HarisGusic/rotating-led-display/README.md

# Rotirajući LED displej

Korišten je mikrokontroler Arduino Mega 2560.

## Izgled konačnog proizvoda

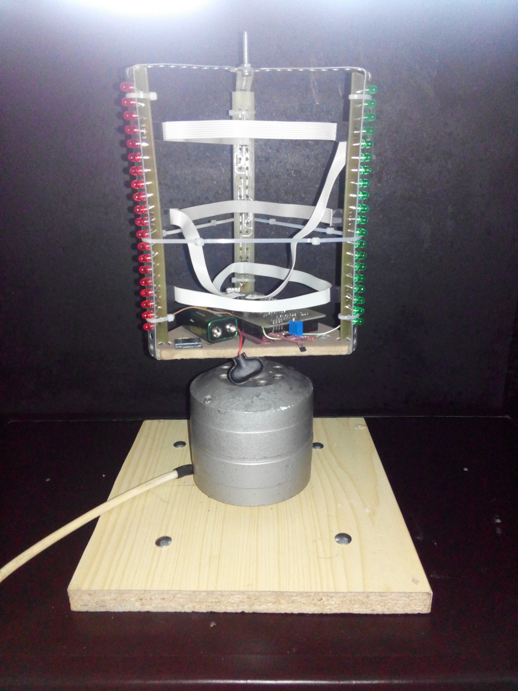
[picture p1: img/FINALNI-PROIZVOD-2.jpg]
Proizvod


## Demonstracija rada

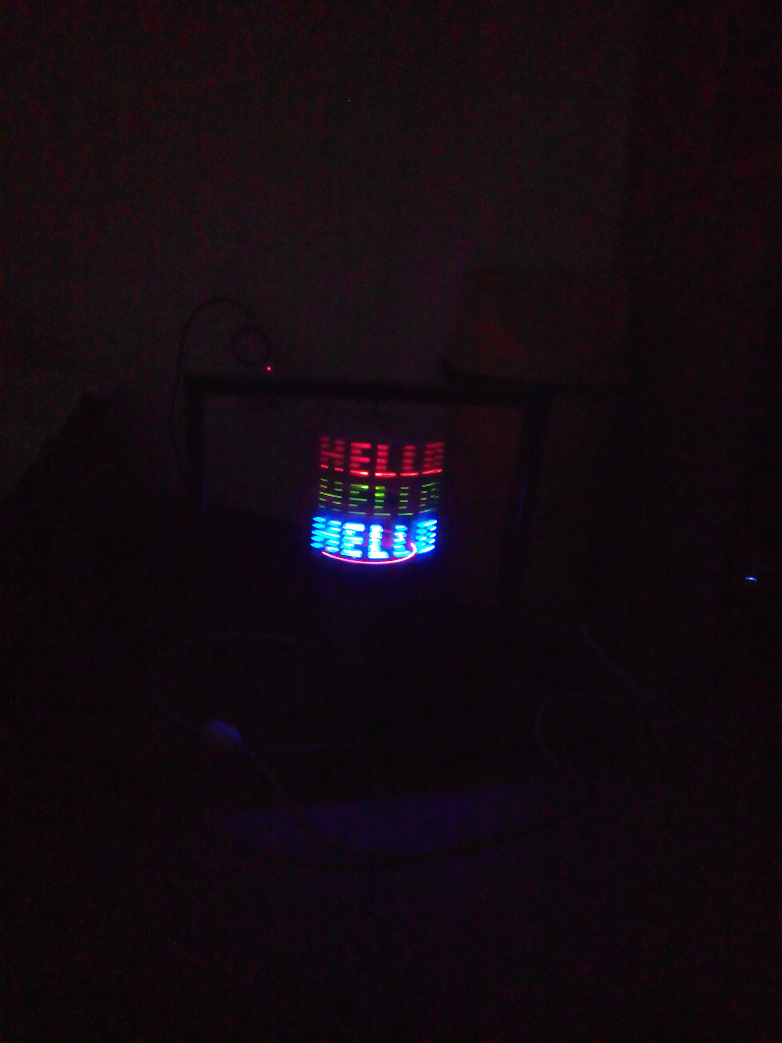
[picture p2: img/hello.jpg]
Hello


## Proces razvoja

### Prototip

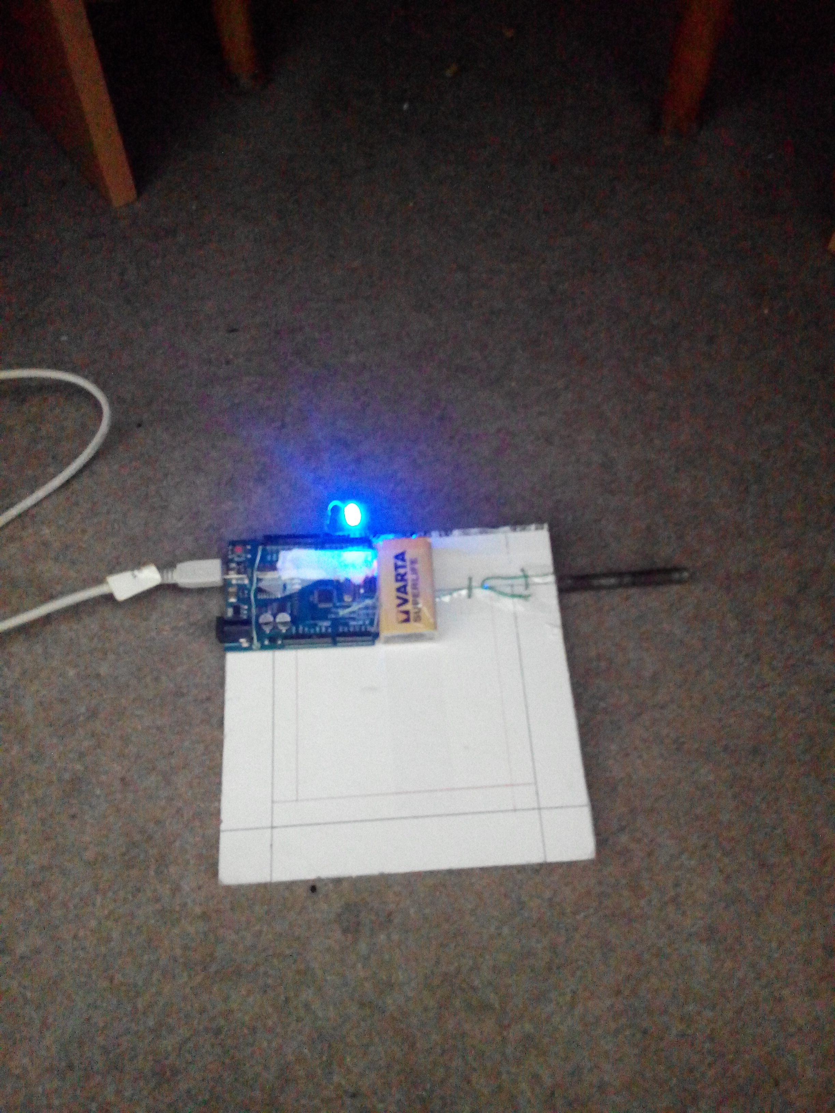
[picture p3: img/prototip.jpg]
Prototip


---

Arduino shield
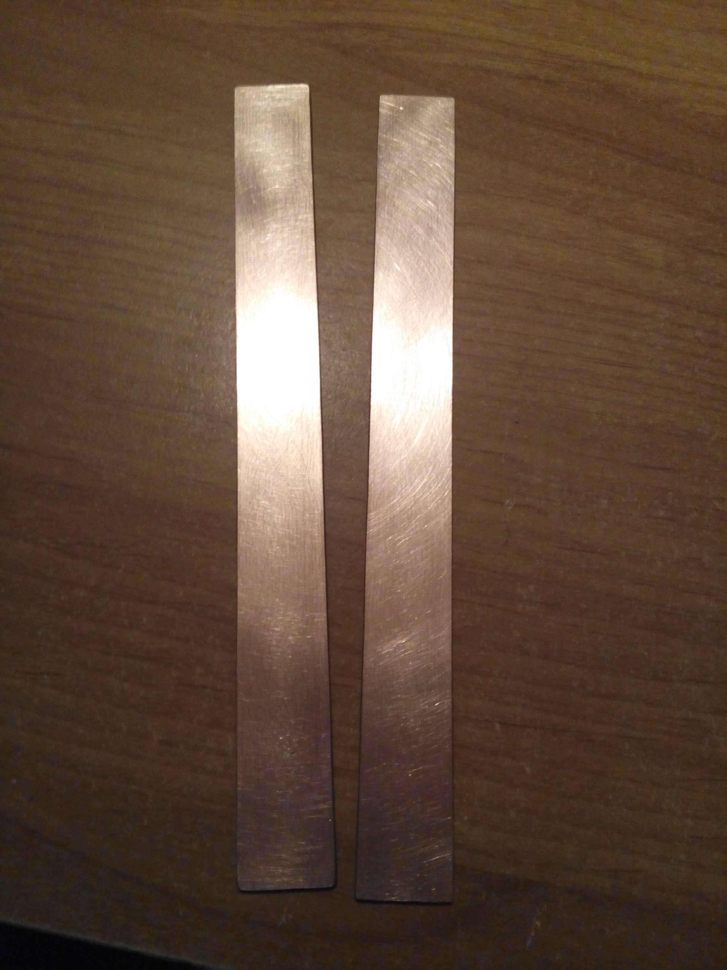
[picture p4: img/pcb-osnova-polish.jpg]
LED PCB

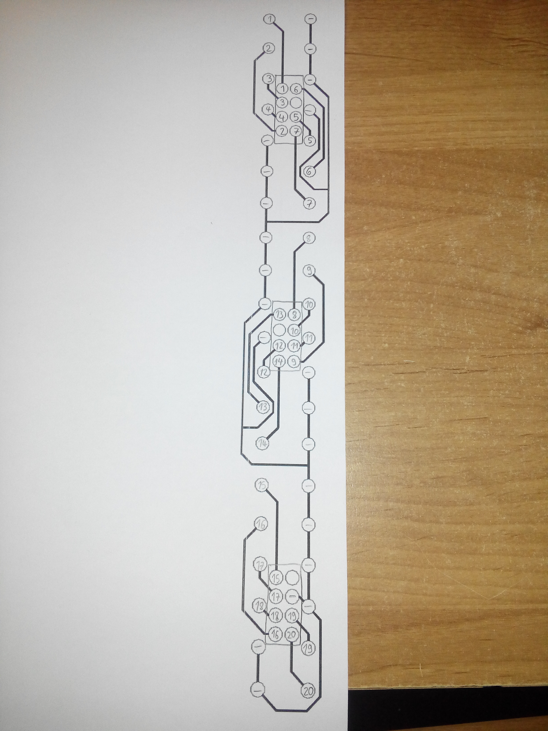
[picture p5: img/led-pcb-print.jpg]
Uvećana shema PCB

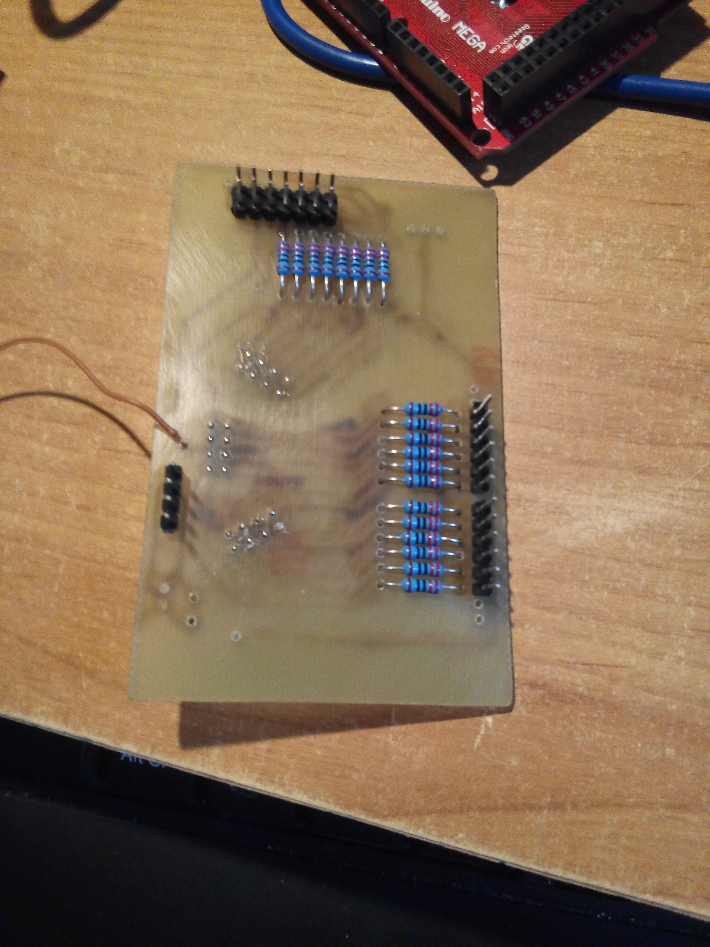
[picture p6: img/arduino-shield-finished.jpg]
Arduino shield

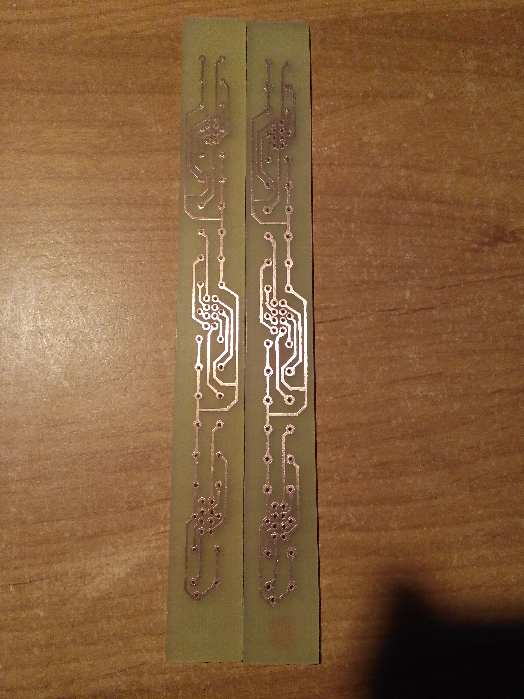
[picture p7: img/led-pcb-finished-2.jpg]
LED PCB gotov

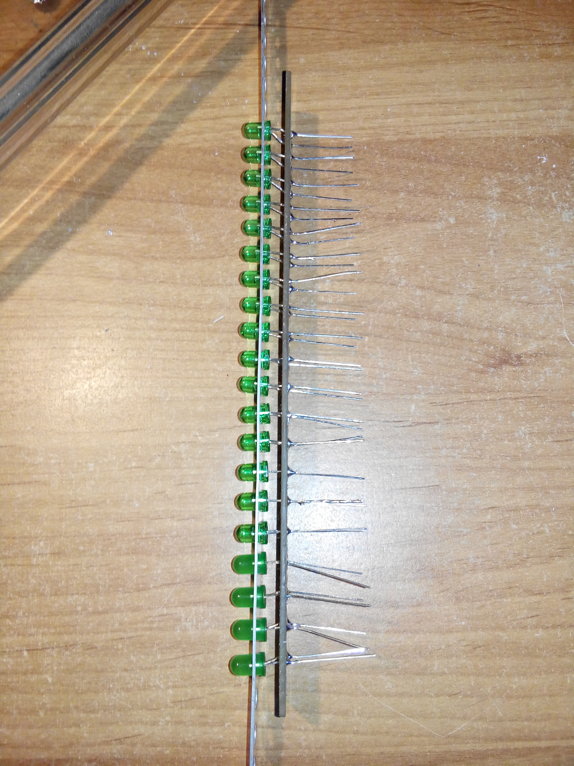
[picture p8: img/led-strip-2.jpg]
Povezane LED

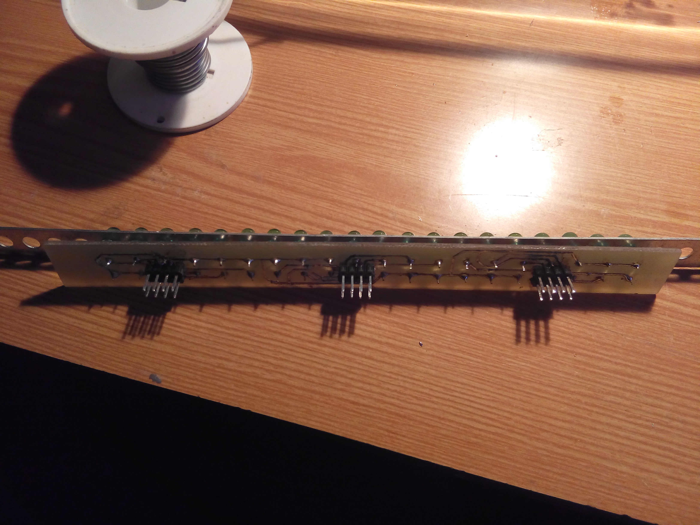
[picture p9: img/led-pcb-konektori.jpg]
LED PCB sa konektorima

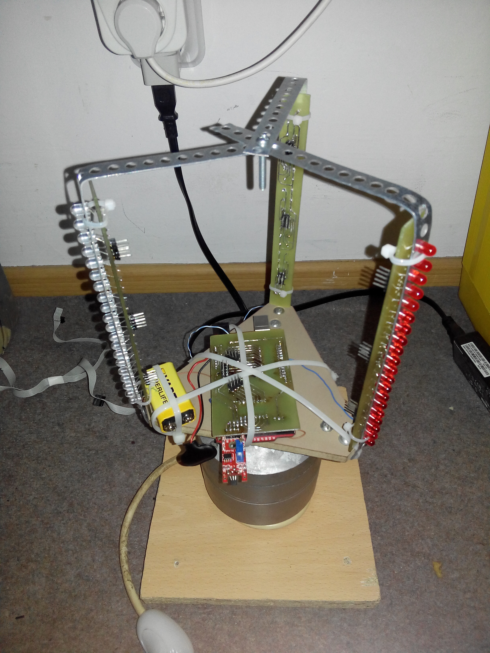
[picture p10: img/assembly.jpg]
Sastavljeno
