HarisGusic/rotating-led-display/pcb/FINALNA-PLOCA-skica.pdf

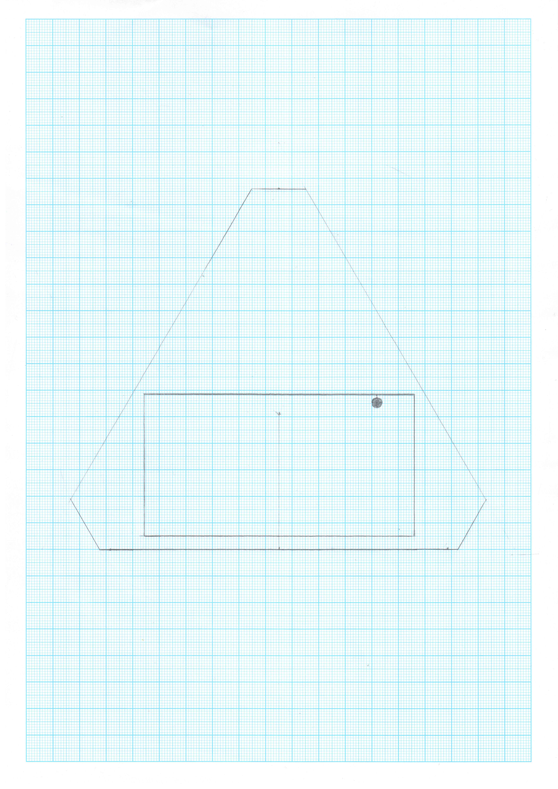
[picture p14: page 1]
