HarisGusic/rotating-led-display/img/arduino-shield-prljav.jpg

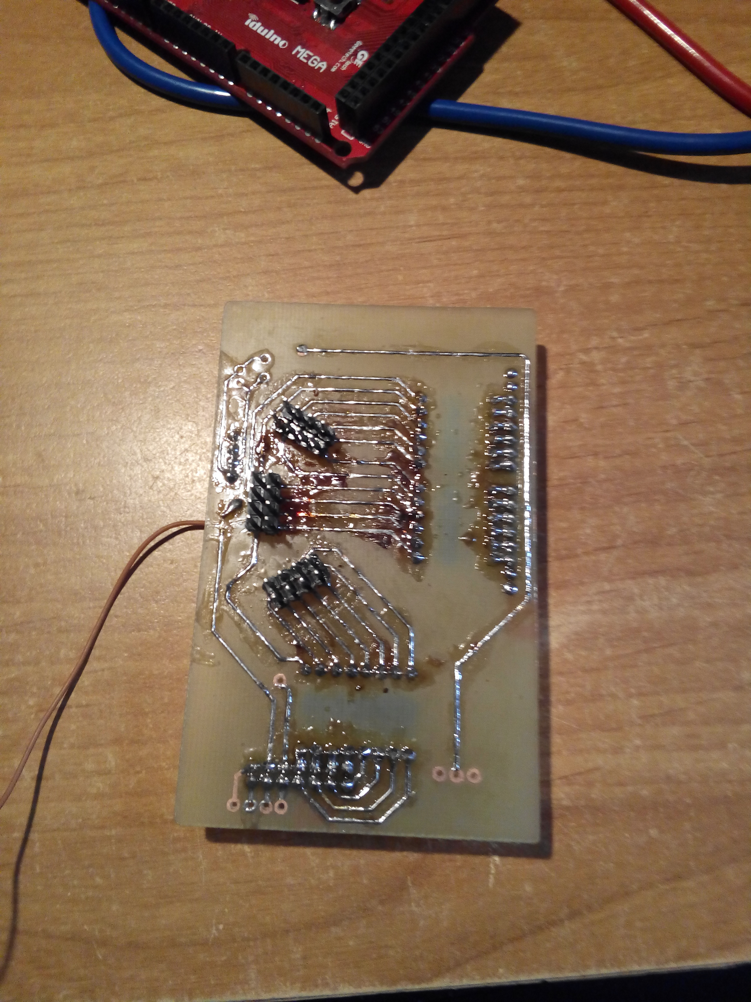
img/arduino-shield-prljav.jpg
