HarisGusic/rotating-led-display/img/FINALNI-PROIZVOD.jpg

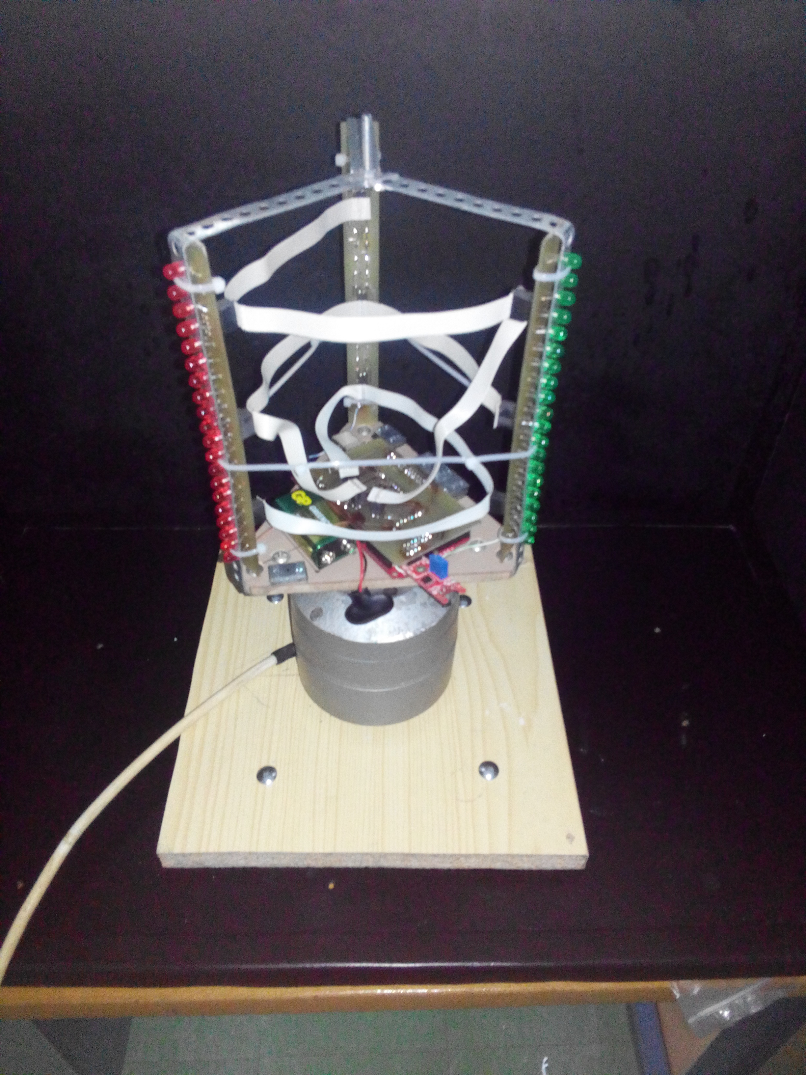
img/FINALNI-PROIZVOD.jpg
