HarisGusic/rotating-led-display/img/IMG_20170425_183837.jpg

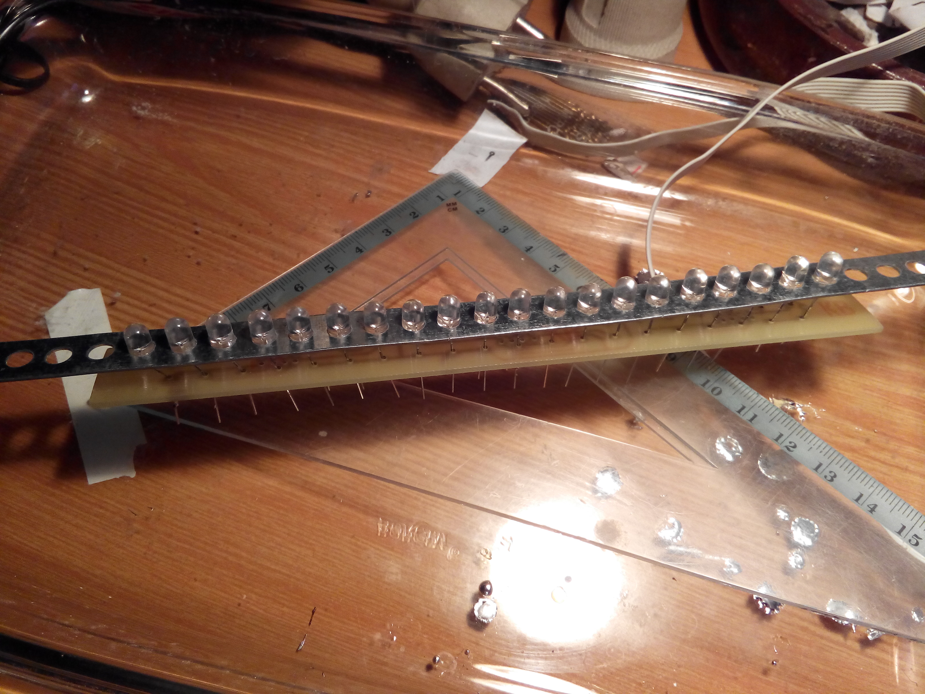
img/IMG_20170425_183837.jpg
