HarisGusic/rotating-led-display/img/IMG_20170426_143059.jpg

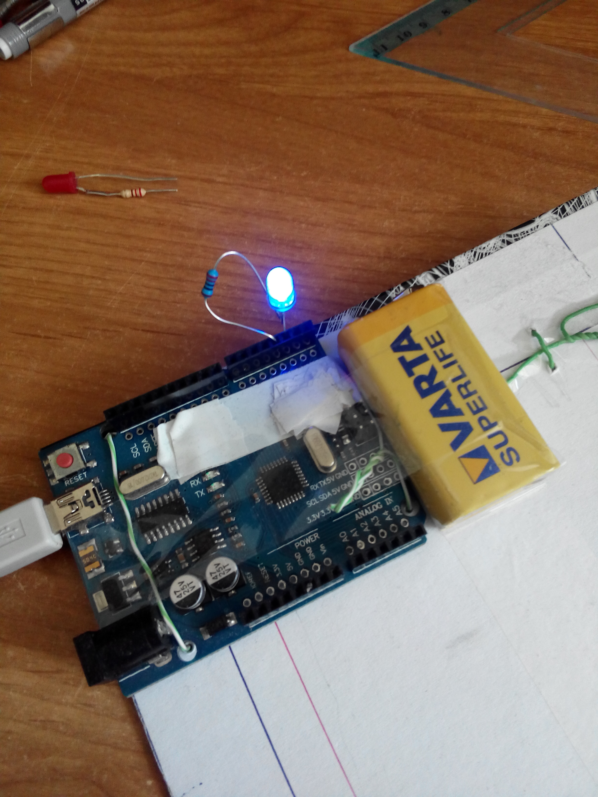
img/IMG_20170426_143059.jpg
