HarisGusic/rotating-led-display/img/IMG_20170501_210211.jpg

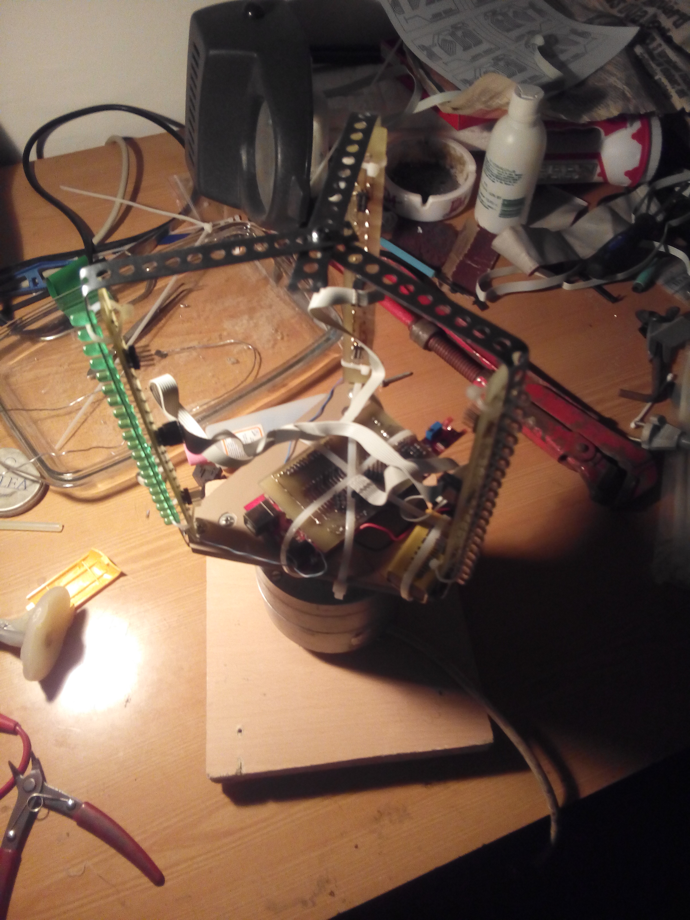
img/IMG_20170501_210211.jpg
