HarisGusic/rotating-led-display/img/IMG_20170501_210226.jpg

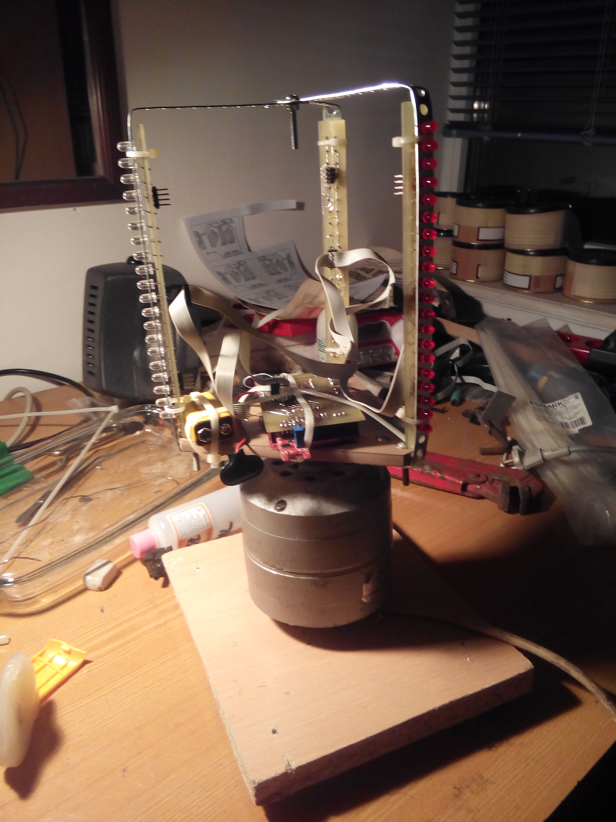
img/IMG_20170501_210226.jpg
