HarisGusic/rotating-led-display/img/IMG_20170503_012216.jpg

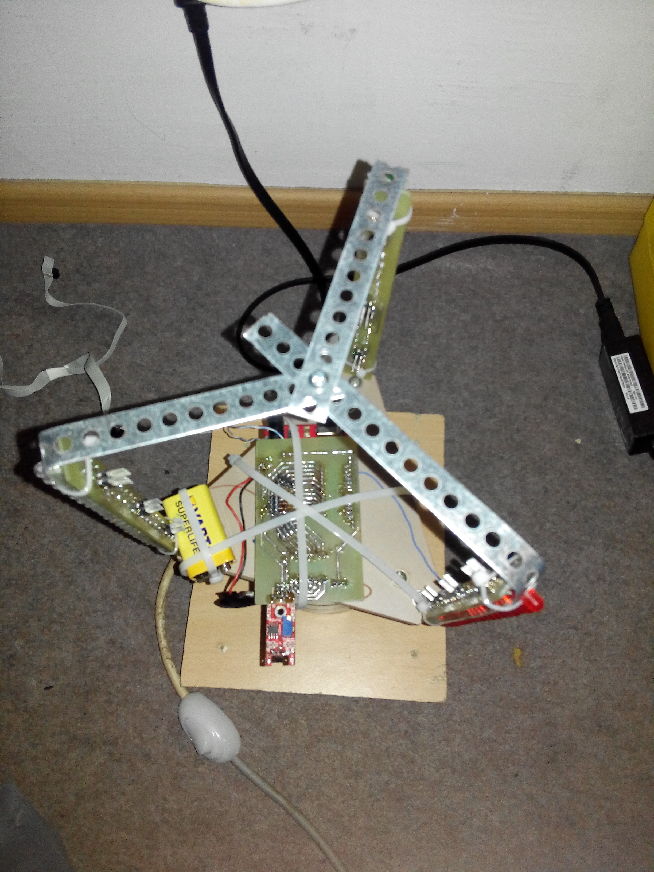
img/IMG_20170503_012216.jpg
