HarisGusic/rotating-led-display/img/IMG_20170503_012233.jpg

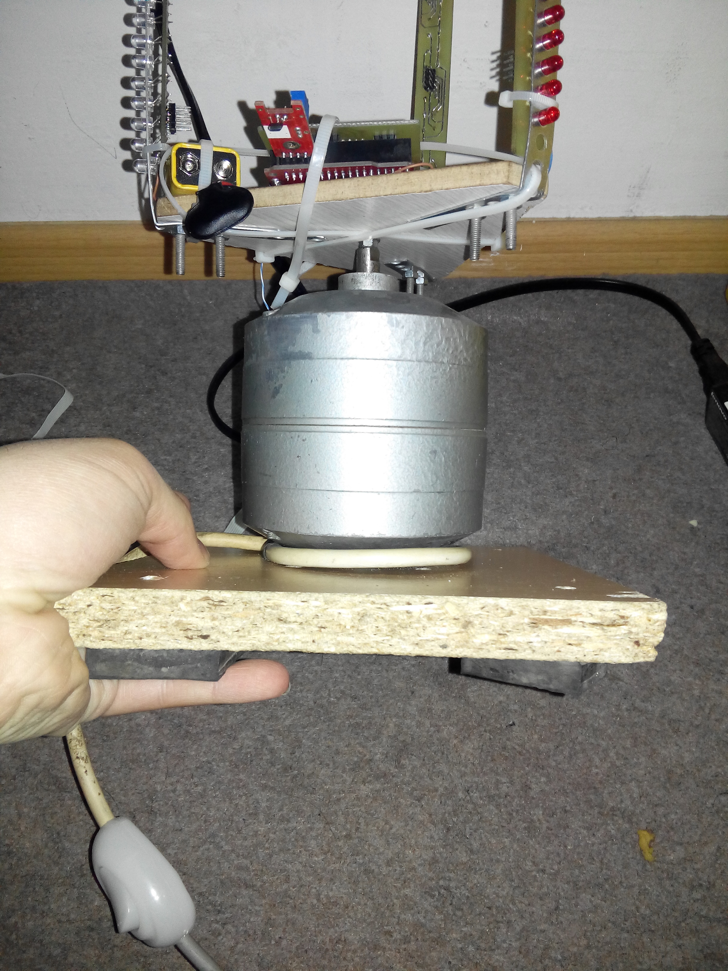
img/IMG_20170503_012233.jpg
