HarisGusic/rotating-led-display/img/IMG_20170503_012245.jpg

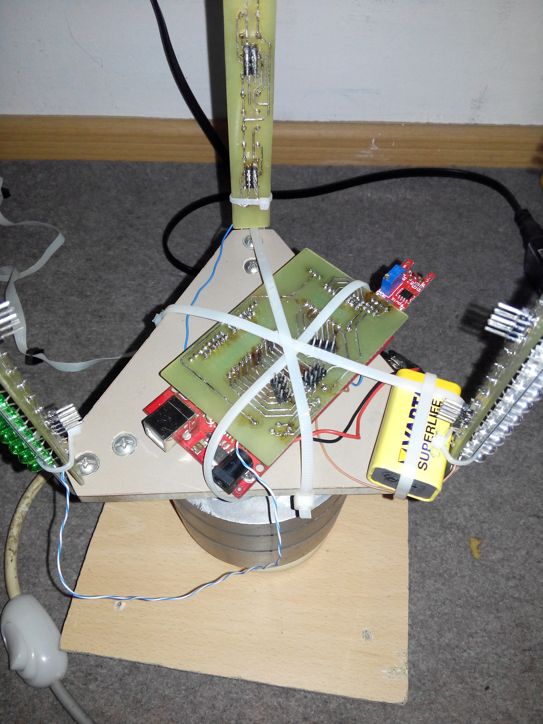
img/IMG_20170503_012245.jpg
