HarisGusic/rotating-led-display/img/led-pcb-finished.jpg

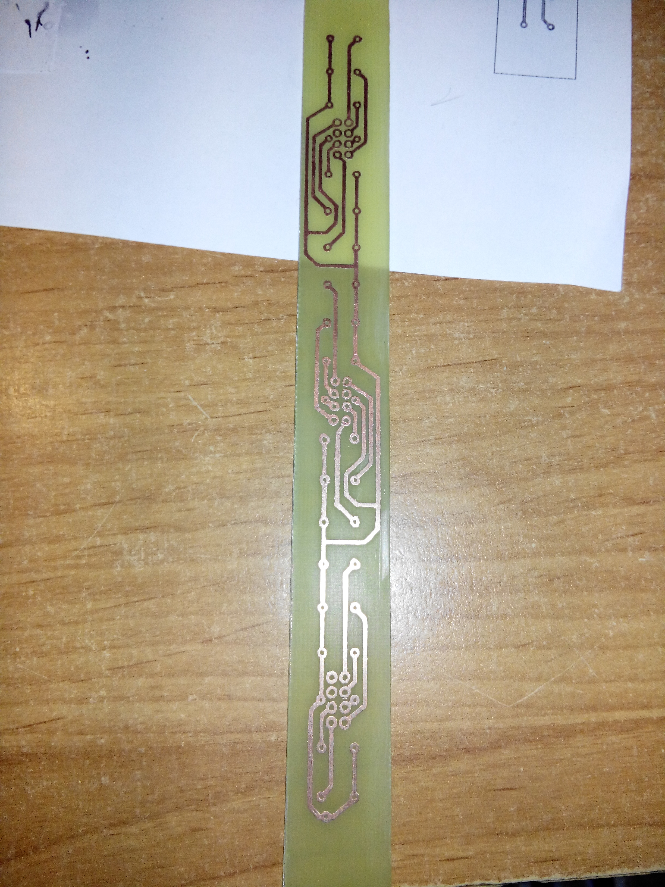
img/led-pcb-finished.jpg
