HarisGusic/rotating-led-display/img/led-strip-3.jpg

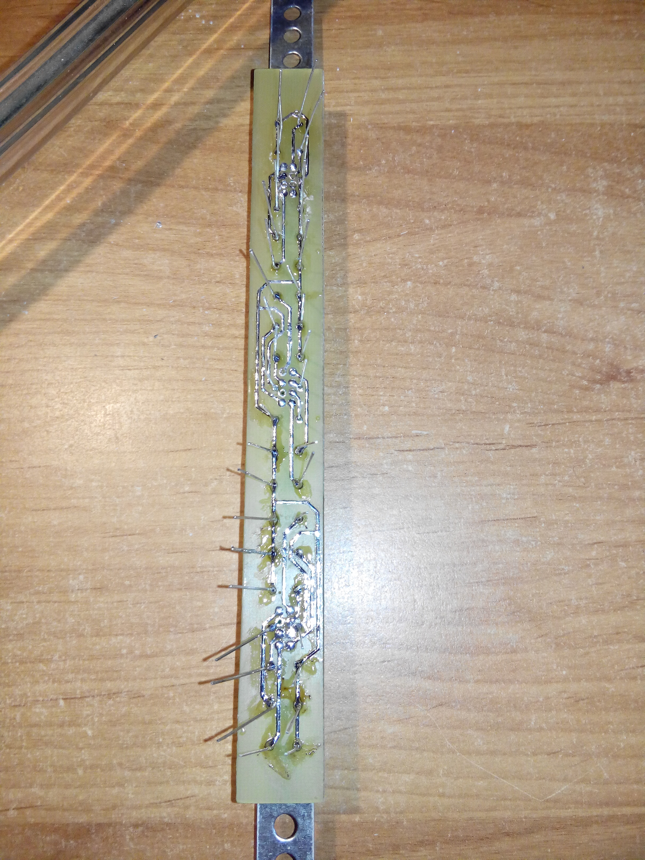
img/led-strip-3.jpg
