HarisGusic/rotating-led-display/img/led-strip.jpg

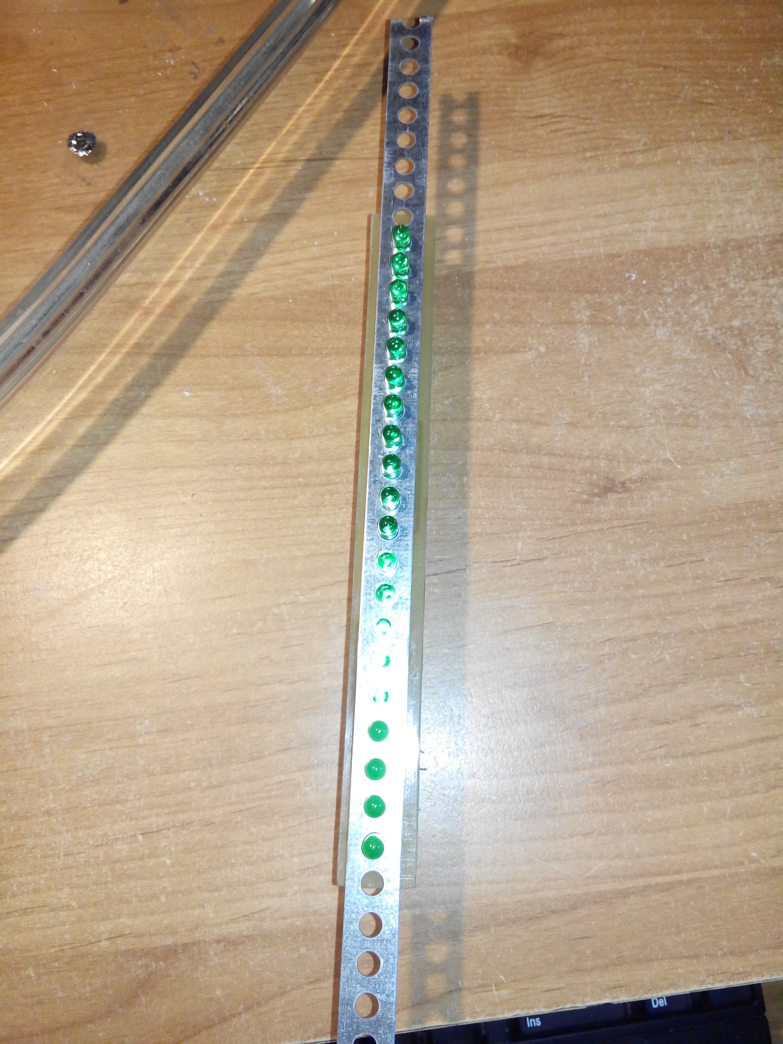
img/led-strip.jpg
