HarisGusic/rotating-led-display/img/prototip-2.jpg

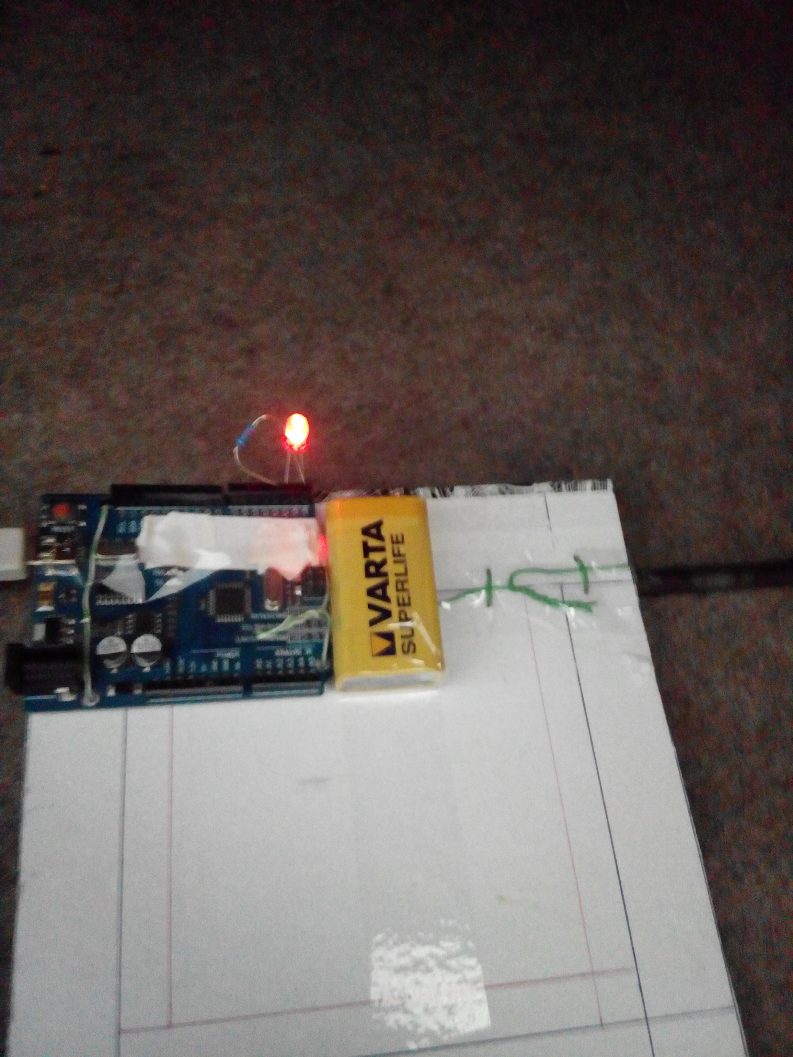
img/prototip-2.jpg
