HarisGusic/rotating-led-display/img/problem-2.jpg

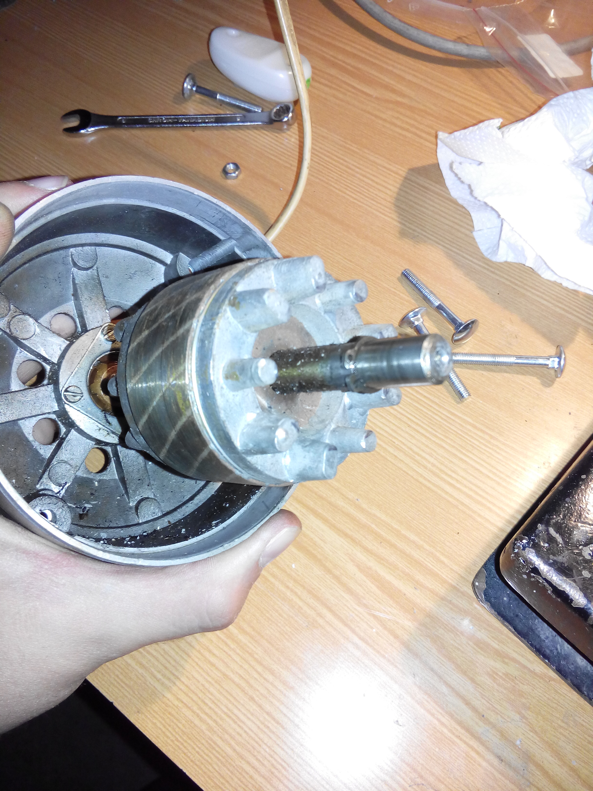
img/problem-2.jpg
