HarisGusic/rotating-led-display/img/problem-3.jpg

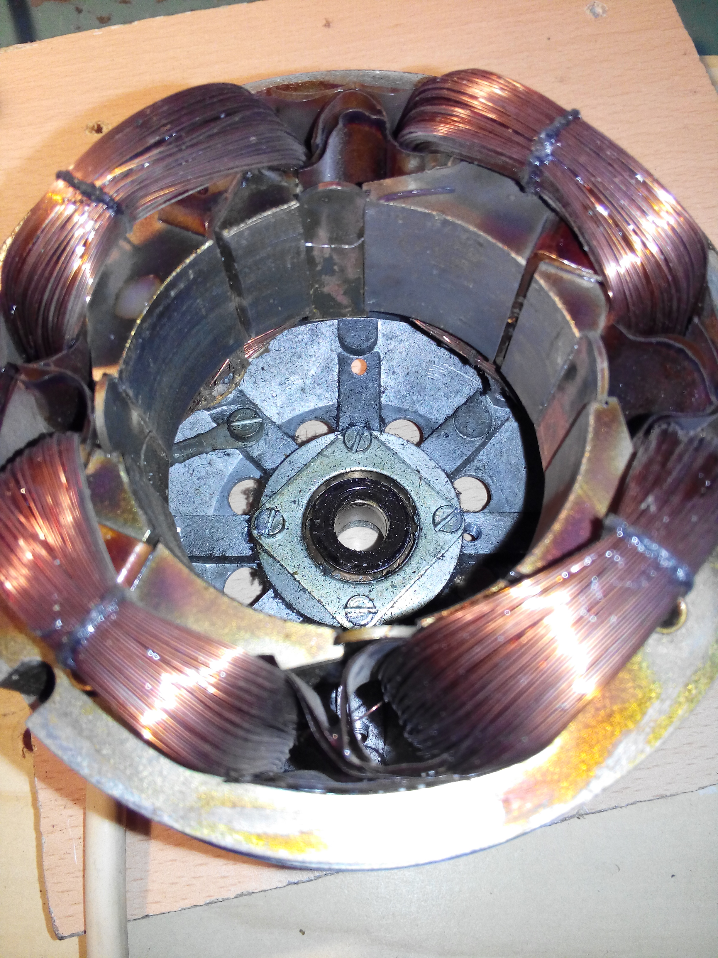
img/problem-3.jpg
