HarisGusic/rotating-led-display/img/problem.jpg

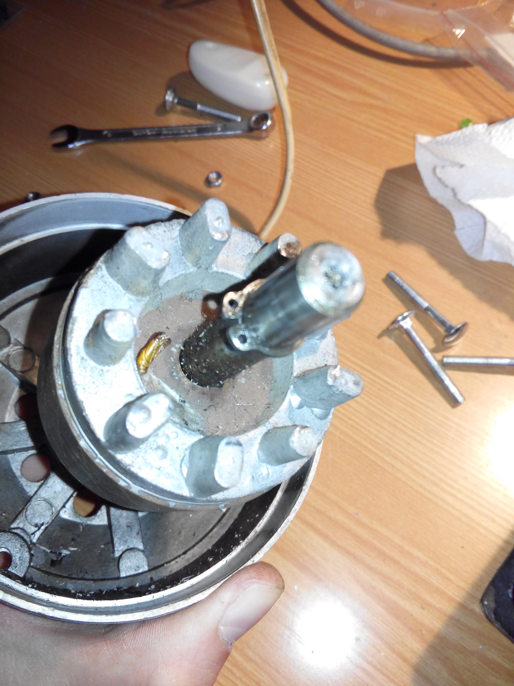
img/problem.jpg
